Jaycar-Electronics/UV-Meter/images/catcable.jpg

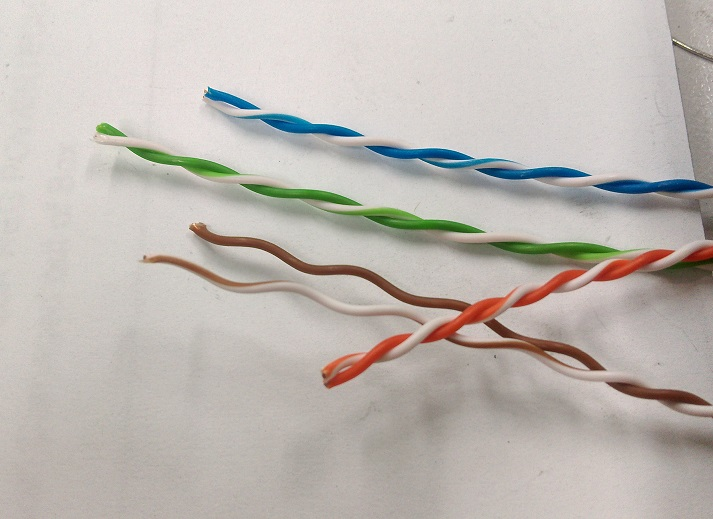
images/catcable.jpg
